EmilPtr/FMP3_PLAYER/FMP3_PLAYER_CIRCUIT_ITER_2/FMP3_PLAYER.kicad_pcb

## KiCad design FMP3_PLAYER_CIRCUIT_ITER_2/FMP3_PLAYER.kicad_pcb (2026-02-22)

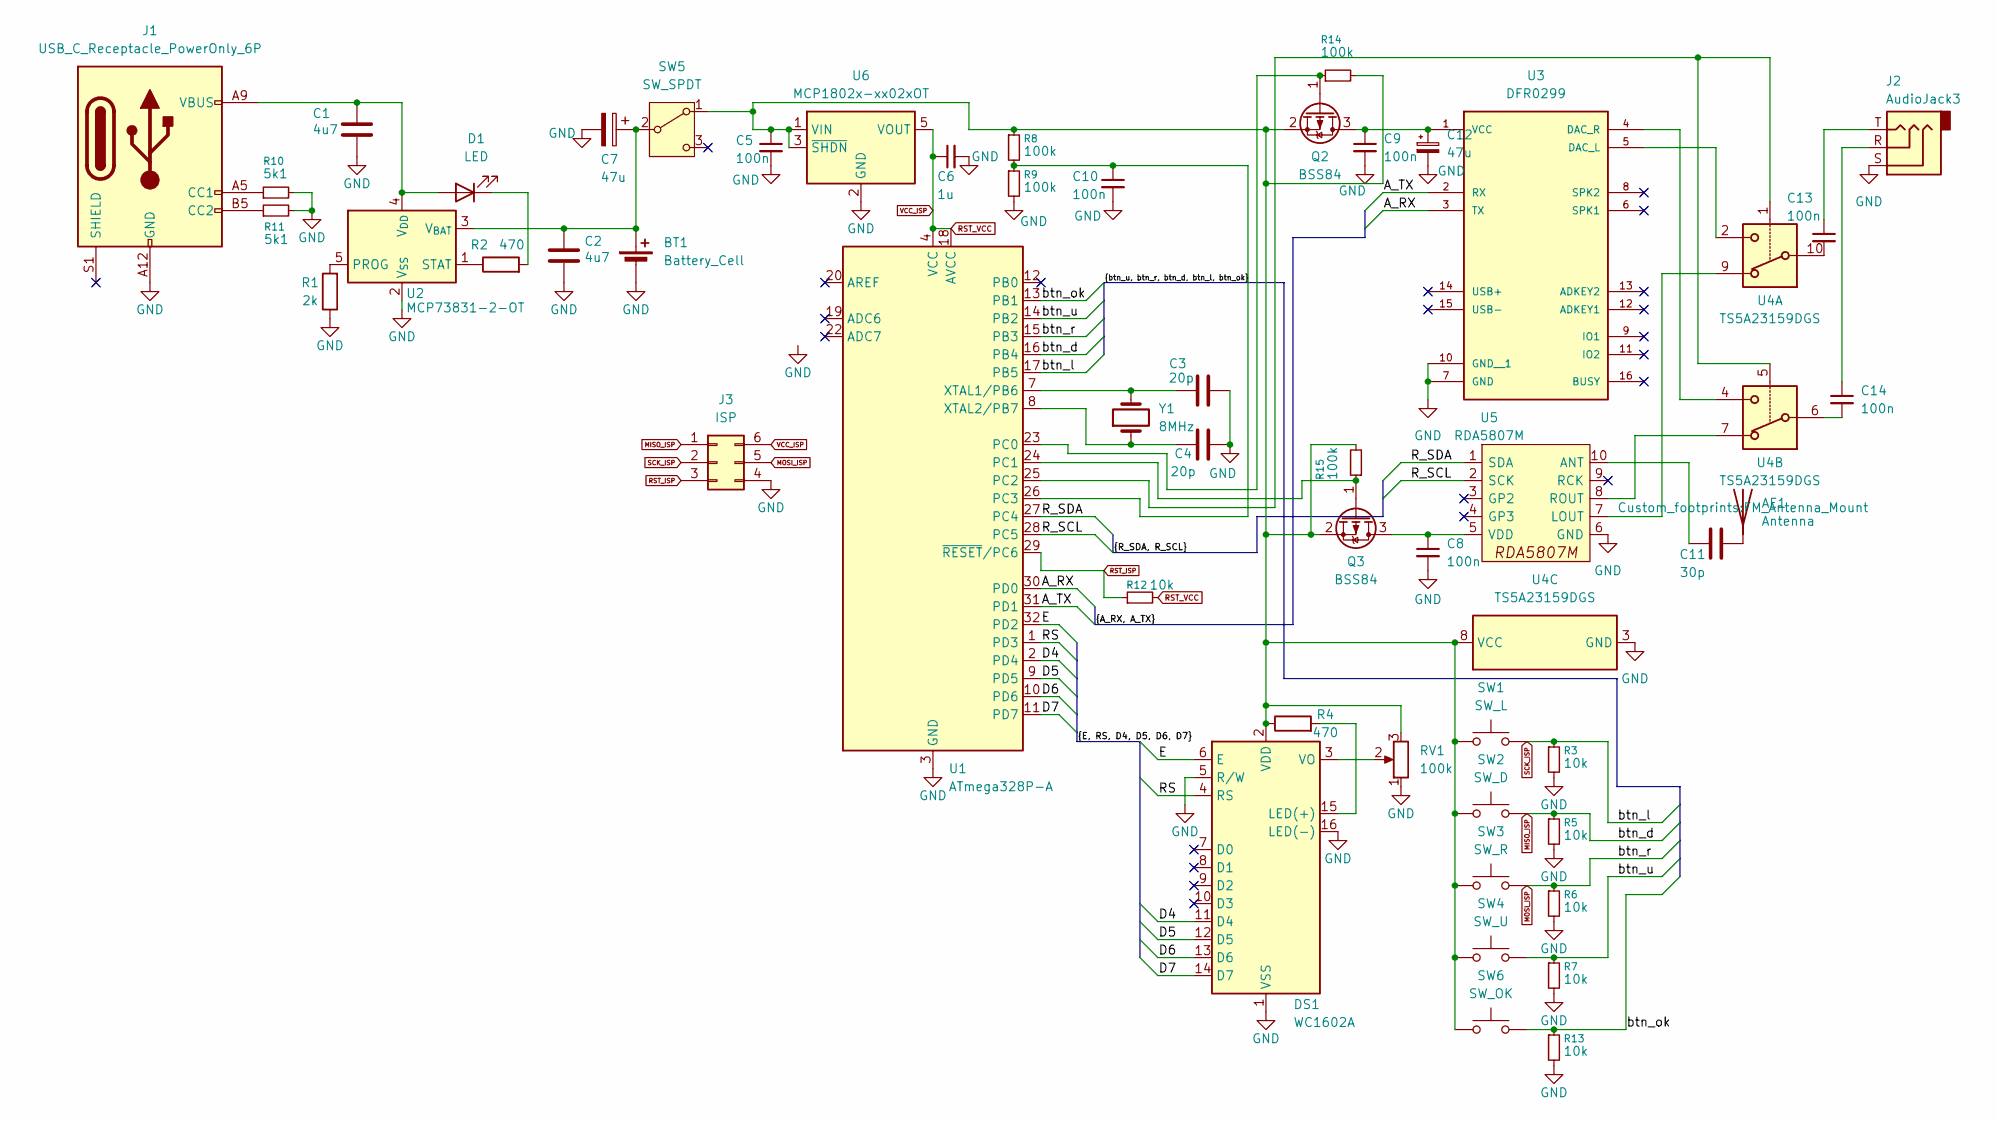
[picture p1: schematic FMP3_PLAYER.kicad_sch]

Parts:
AE1: Antenna; FM_Antenna_Mount
BT1: Battery_Cell; JST_PH_B2B-PH-K_1x02_P2.00mm_Vertical
C1, C2: 4u7; C_0805_2012Metric_Pad1.18x1.45mm_HandSolder
C3, C4: 20p; C_0805_2012Metric_Pad1.18x1.45mm_HandSolder
C5, C8, C9, C10, C13, C14: 100n; C_0805_2012Metric_Pad1.18x1.45mm_HandSolder
C6: 1u; C_0805_2012Metric_Pad1.18x1.45mm_HandSolder
C7, C12: 47u; CP_Radial_D5.0mm_P2.50mm
C11: 30p; C_0805_2012Metric_Pad1.18x1.45mm_HandSolder
D1: LED; LED_D5.0mm
DS1: WC1602A; PinSocket_1x16_P2.54mm_Vertical
J1: USB_C_Receptacle_PowerOnly_6P; USB_C_Receptacle_GCT_USB4125-xx-x-0190_6P_TopMnt_Horizontal
J2: AudioJack3; Jack_3.5mm_CUI_SJ-3523-SMT_Horizontal
J3: ISP; PinHeader_2x03_P2.54mm_Vertical
Q2, Q3: BSS84; SOT-23_Handsoldering
R1: 2k; R_0805_2012Metric_Pad1.20x1.40mm_HandSolder
R2, R4: 470; R_0805_2012Metric_Pad1.20x1.40mm_HandSolder
R3, R5, R6, R7, R12, R13: 10k; R_0805_2012Metric_Pad1.20x1.40mm_HandSolder
R8, R9, R14, R15: 100k; R_0805_2012Metric_Pad1.20x1.40mm_HandSolder
R10, R11: 5k1; R_0805_2012Metric_Pad1.20x1.40mm_HandSolder
RV1: 100k; Potentiometer_Bourns_3339P_Vertical
SW1: SW_L; SW_Push_1P1T_NO_CK_KSC9xxG
SW2: SW_D; SW_Push_1P1T_NO_CK_KSC9xxG
SW3: SW_R; SW_Push_1P1T_NO_CK_KSC9xxG
SW4: SW_U; SW_Push_1P1T_NO_CK_KSC9xxG
SW5: SW_SPDT; SW_Slide_SPDT_Angled_CK_OS102011MA1Q
SW6: SW_OK; SW_Push_1P1T_NO_CK_KSC9xxG
U1: ATmega328P-A; TQFP-32_7x7mm_P0.8mm
U2: MCP73831-2-OT; SOT-23-5
U3: DFR0299; MODULE_DFR0299
U4: TS5A23159DGS; VSSOP-10_3x3mm_P0.5mm
U5: RDA5807M; RDA5807M Module
U6: MCP1802x-xx02xOT; SOT-23-5
Y1: 8MHz; Crystal_HC49-4H_Vertical

Connections:
/A_RX: U1.30 (PD0), U3.3 (TX)
/A_TX: U1.31 (PD1), U3.2 (RX)
/D4: DS1.11 (D4), U1.2 (PD4)
/D5: DS1.12 (D5), U1.9 (PD5)
/D6: DS1.13 (D6), U1.10 (PD6)
/D7: DS1.14 (D7), U1.11 (PD7)
/E: DS1.6 (E), U1.32 (PD2)
/RS: DS1.4 (RS), U1.1 (PD3)
/R_SCL: U1.28 (PC5), U5.2 (SCK)
/R_SDA: U1.27 (PC4), U5.1 (SDA)
/btn_ok: R13.1, SW6.2, U1.13 (PB1)
/btn_u: R7.1, SW4.2, U1.14 (PB2)
GND: BT1.2 (-), C1.2, C2.2, C3.2, C4.2, C5.2, C6.2, C7.2, C8.2, C9.2, C10.2, C12.2, DS1.1 (VSS), DS1.5 (R/W), DS1.16 (LED(-)), J1.A12 (GND), J1.B12 (GND), J2.S, J3.4, R1.1, R3.2, R5.2, R6.2, R7.2, R9.2, R10.2, R11.2, R13.2, RV1.1, U1.3 (GND), U1.5 (GND), U1.21 (GND), U2.2 (V_{SS}), U3.7 (GND), U3.10 (GND__1), U4.3 (GND), U5.6 (GND), U6.2 (GND)
MISO_ISP: J3.1, R5.1, SW2.2, U1.16 (PB4)
MOSI_ISP: J3.5, R6.1, SW3.2, U1.15 (PB3)
unnamed: AE1.1 (A), C11.2
unnamed: BT1.1 (+), C2.1, C7.1, SW5.2 (B), U2.3 (V_{BAT})
unnamed: C13.1, J2.T
unnamed: C13.2, U4.10
unnamed: C14.1, J2.R
unnamed: C14.2, U4.6
unnamed: C1.1, D1.2 (A), J1.A9 (VBUS), J1.B9 (VBUS), U2.4 (V_{DD})
unnamed: D1.1 (K), R2.2
unnamed: DS1.15 (LED(+)), R4.2
unnamed: C5.1, DS1.2 (VDD), Q2.2 (S), Q3.2 (S), R4.1, R8.1, R14.2, R15.2, RV1.3, SW1.1, SW2.1, SW3.1, SW4.1, SW5.1 (A), SW6.1, U4.8 (VCC), U6.1 (VIN), U6.3 (~SHDN)
unnamed: DS1.3 (VO), RV1.2
unnamed: J1.A5 (CC1), R10.1
unnamed: J1.B5 (CC2), R11.1
unnamed: C9.1, C12.1, Q2.3 (D), U3.1 (VCC)
unnamed: Q2.1 (G), R14.1, U1.23 (PC0)
unnamed: C8.1, Q3.3 (D), U5.5 (VDD)
unnamed: Q3.1 (G), R15.1, U1.24 (PC1)
unnamed: U1.25 (PC2), U4.1, U4.5
unnamed: C10.1, R8.2, R9.1, U1.26 (PC3)
unnamed: C3.1, U1.7 (XTAL1/PB6), Y1.2
unnamed: C4.1, U1.8 (XTAL2/PB7), Y1.1
unnamed: R1.2, U2.5 (PROG)
unnamed: R2.1, U2.1 (STAT)
unnamed: U3.5 (DAC_L), U4.2
unnamed: U3.4 (DAC_R), U4.4
unnamed: C11.1, U5.10 (ANT)
unnamed: U4.9, U5.7 (LOUT)
unnamed: U4.7, U5.8 (ROUT)
RST_ISP: J3.3, R12.1, U1.29 (~RESET/PC6)
RST_VCC: C6.1, J3.6, R12.2, U1.4 (VCC), U1.6 (VCC), U1.18 (AVCC), U6.5 (VOUT)
SCK_ISP: J3.2, R3.1, SW1.2, U1.17 (PB5)

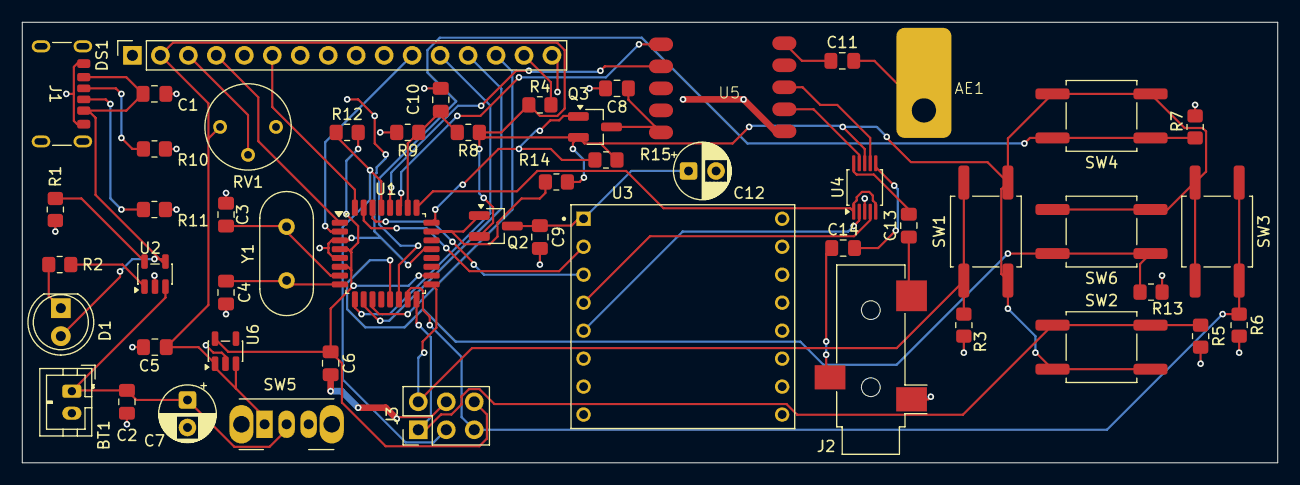
[picture p2: board FMP3_PLAYER.kicad_pcb from above]

Board: 2 copper layers, 114.0 x 40.0 mm, 52 parts (0 on the bottom side), 46 nets.
