EmilPtr/FMP3_PLAYER/(commit log)

2026-02-18 I should probably start tracking work here...
    [FMP3_PLAYER.kicad_pcb, FMP3_PLAYER.kicad_sch]
2026-02-19 Started a new iteration cause 4 layer to expensive
    [FMP3_PLAYER.kicad_pcb, FMP3_PLAYER.kicad_sch]
2026-02-19 Second iteration complete, much cheaper to manufacture
    [FMP3_PLAYER.kicad_pcb]
2026-02-19 sent out for manu, digikey order made, cant wait
    [FMP3_PLAYER.kicad_pcb]
2026-02-20 The DFPlayer NEEDS a fat decoupling cap...
    [FMP3_PLAYER.kicad_pcb, FMP3_PLAYER.kicad_sch]
2026-02-20 I swear to git this is the final pcb...
    [FMP3_PLAYER.kicad_pcb, FMP3_PLAYER.kicad_sch]
2026-02-22 I realized after some prototyping my PMOS was bad, fixed now, i swear this better be the final...
    [FMP3_PLAYER.kicad_pcb, FMP3_PLAYER.kicad_sch]
2026-02-22 minor fix, used pulldowns instead of pullups by accident
    [FMP3_PLAYER.kicad_pcb, FMP3_PLAYER.kicad_sch]
2026-02-22 another minor fix, i should really go sleep...
    [FMP3_PLAYER.kicad_pcb, FMP3_PLAYER.kicad_sch]
2026-02-24 MP3 works very well, but FM is incredibly broken, maybe the chip is bad? idj
    [helpers.cpp, helpers.h, main.cpp]
